cuasay2/Backpack-Buddy/Hardware/ATMEGA32U4-AU.step

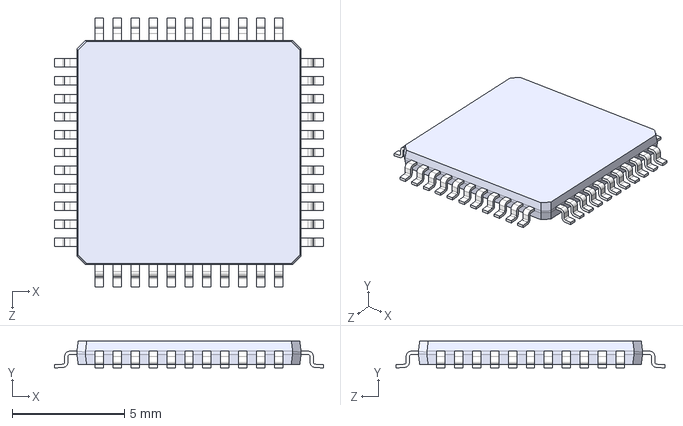
[picture p2: CAD file, 2023-02-20]
Hardware/ATMEGA32U4-AU.step
12.0 x 1.20 x 12.0 mm
