cuasay2/Backpack-Buddy/Hardware/System/backpackbuddy_system/backpackbuddy_system.kicad_pcb

## KiCad design Hardware/System/backpackbuddy_system/backpackbuddy_system.kicad_pcb (2023-04-06)

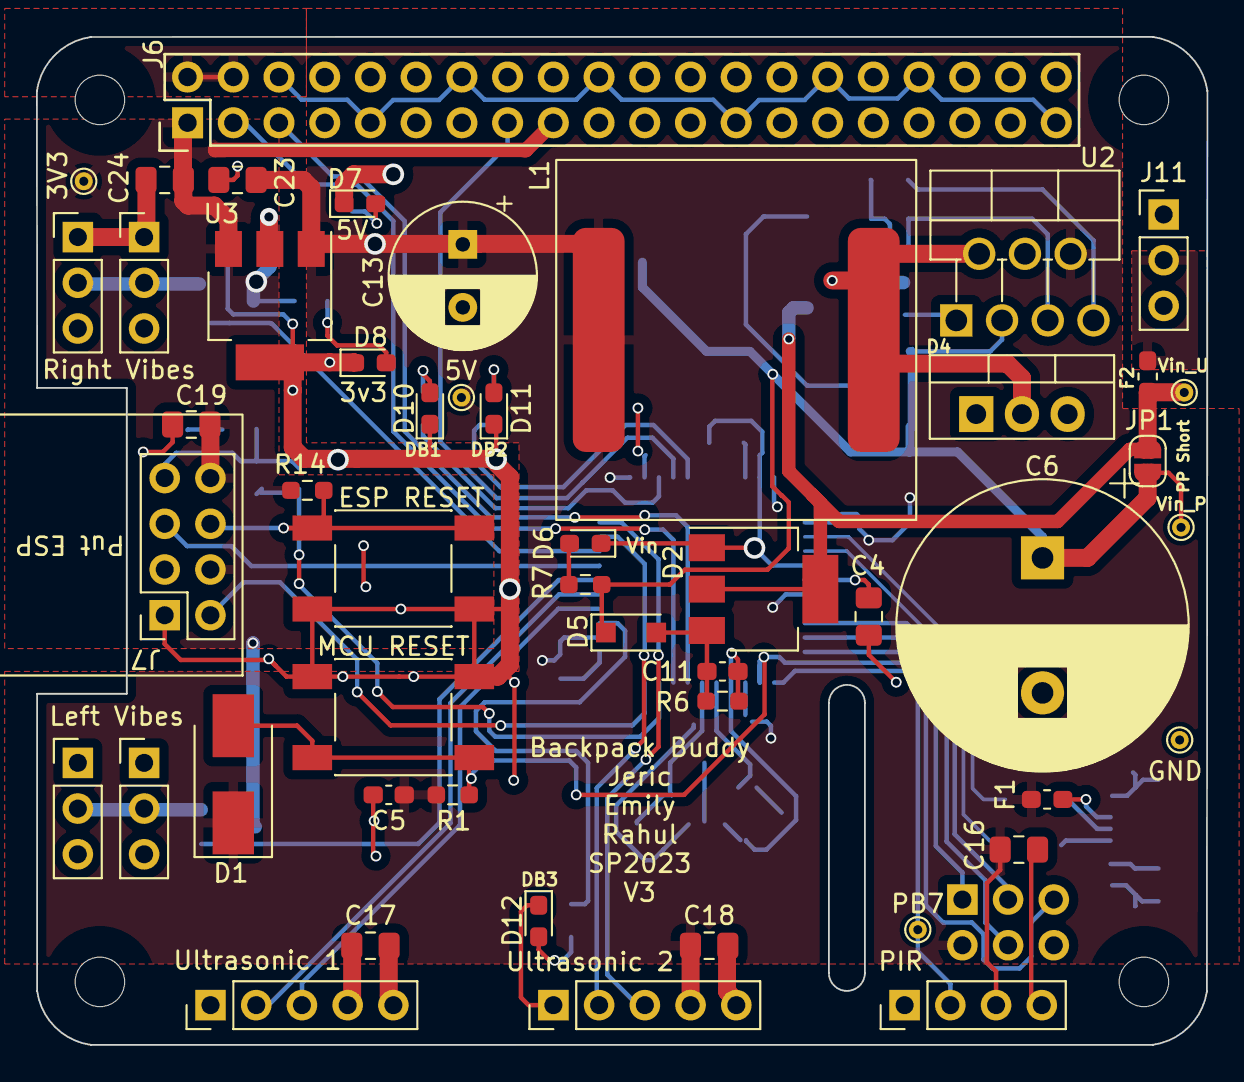
[picture p3: board backpackbuddy_system.kicad_pcb from above]

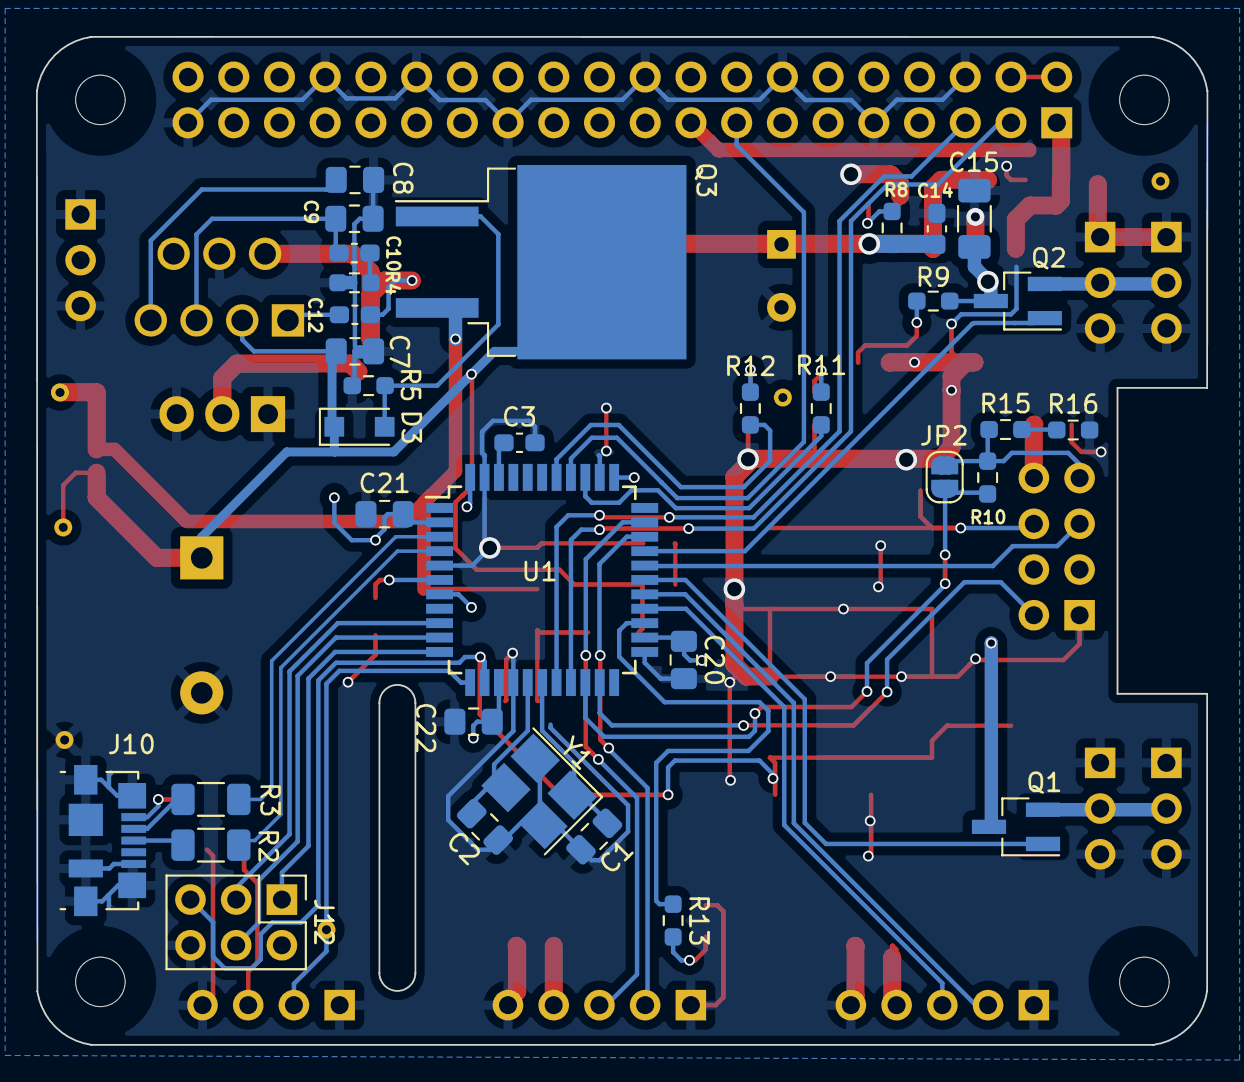
[picture p4: board backpackbuddy_system.kicad_pcb from below]

Board: 2 copper layers, 65.0 x 56.0 mm, 87 parts (34 on the bottom side), 53 nets.

Parts:
C1, C2: 22pF; C_0805_2012Metric_Pad1.18x1.45mm_HandSolder
C3, C5, C11: 0.1uF; C_0603_1608Metric_Pad1.08x0.95mm_HandSolder
C4: 1uF; C_0805_2012Metric_Pad1.18x1.45mm_HandSolder
C6: 2200uF; CP_Radial_D16.0mm_P7.50mm
C7: 4.7uF; C_0805_2012Metric_Pad1.18x1.45mm_HandSolder
C8, C16, C17, C18, C19, C20, C21, C22, C23, C24: 10uF; C_0805_2012Metric_Pad1.18x1.45mm_HandSolder
C9: 680pF; C_0805_2012Metric_Pad1.18x1.45mm_HandSolder
C10: 1200pF; C_0603_1608Metric_Pad1.08x0.95mm_HandSolder
C12: 0.22uF; C_0603_1608Metric_Pad1.08x0.95mm_HandSolder
C13: 470uF; CP_Radial_D8.0mm_P3.50mm
C14: 0.47uF; C_0603_1608Metric_Pad1.08x0.95mm_HandSolder
C15: 33uF; C_1206_3216Metric_Pad1.33x1.80mm_HandSolder
D1: 1V; D_SMB_Handsoldering
D2: S602TS; SOT-223-3_TabPin2
D3: 20V; D_SOD-123F
D4: FMW-2156; TO-220-3_Vertical
D5: 27V; D_SOD-123F
D6: Vin; LED_0603_1608Metric_Pad1.05x0.95mm_HandSolder
D7: 5V; LED_0603_1608Metric_Pad1.05x0.95mm_HandSolder
D8: 3v3; LED_0603_1608Metric_Pad1.05x0.95mm_HandSolder
D10: DB1; LED_0603_1608Metric_Pad1.05x0.95mm_HandSolder
D11: DB2; LED_0603_1608Metric_Pad1.05x0.95mm_HandSolder
D12: DB3; LED_0603_1608Metric_Pad1.05x0.95mm_HandSolder
F1: 500mA; Fuse_0603_1608Metric_Pad1.05x0.95mm_HandSolder
F2: 4A; Fuse_0603_1608Metric_Pad1.05x0.95mm_HandSolder
H1, H2, H3, H4: MountingHole; RPi_Hat_Mounting_Hole
J1: PIR; PinHeader_1x04_P2.54mm_Vertical
J2: Ultrasonic 2; PinHeader_1x05_P2.54mm_Vertical
J3: Ultrasonic 1; PinHeader_1x05_P2.54mm_Vertical
J4: Left Vibes; PinHeader_1x03_P2.54mm_Vertical
J5: Left Vibration 2; PinHeader_1x03_P2.54mm_Vertical
J6: RPi_GPIO; Pin_Header_Straight_2x20
J7: ESP8266
J8: Right Vibes; PinHeader_1x03_P2.54mm_Vertical
J9: Right Vibration 2; PinHeader_1x03_P2.54mm_Vertical
J10: USB_B_Micro; USB_Micro-B_Molex_47346-0001
J11: Battery; PinHeader_1x03_P2.54mm_Vertical
J12: ICSP; PinHeader_2x03_P2.54mm_Vertical
JP1, JP2: PP Short; SolderJumper-2_P1.3mm_Open_RoundedPad1.0x1.5mm
L1: 56uH; Inductor_IHLP6767GZER560M11
PB7: PIR; TestPoint_THTPad_D1.0mm_Drill0.5mm
Q1, Q2: Q_NMOS_GSD; SOT-23_Handsoldering
Q3: SIHF9Z24STRR-GE3; TO-263-2
R1, R7, R14: 10k; R_0603_1608Metric_Pad0.98x0.95mm_HandSolder
R2, R3: 22; R_1206_3216Metric_Pad1.30x1.75mm_HandSolder
R4: 39k; R_0603_1608Metric_Pad0.98x0.95mm_HandSolder
R5, R6, R8, R9, R10, R11, R12, R13, R15, R16: 1k; R_0603_1608Metric_Pad0.98x0.95mm_HandSolder
SW1: ESP RESET; RST_SW
SW2: MCU RESET; RST_SW
TP1: Vin_U; TestPoint_THTPad_D1.0mm_Drill0.5mm
TP2: GND; TestPoint_THTPad_D1.0mm_Drill0.5mm
TP3: Vin_P; TestPoint_THTPad_D1.0mm_Drill0.5mm
TP4: 5V; TestPoint_THTPad_D1.0mm_Drill0.5mm
TP5: 3V3; TestPoint_THTPad_D1.0mm_Drill0.5mm
U1: ATmega32U4-A; TQFP-44_10x10mm_P0.8mm
U2: SI-8050Y; TO-220F-7_P2.54x3.7mm_StaggerOdd_Lead3.5mm_Vertical
U3: LM3940; SOT-223
Y1: 16MHz; Crystal_SMD_3225-4Pin_3.2x2.5mm_HandSoldering

Connections:
+3V3: C15.1, C19.1, C24.1, J6.1, J6.17, J7.4, J7.8, Q1.3 (D), Q2.3 (D), R9.1, R14.1, TP5.1, U3.3 (Vout)
+5V: C5.1, C13.1, C14.1, C16.1, C17.1, C18.1, C20.1, C21.1, C22.1, C23.1, D1.1 (K), F1.2, J1.3, J2.4, J3.4, J6.2, J6.4, J12.2, L1.2, R1.1, R8.1, TP4.1, U1.2 (UVCC), U1.7 (VBUS), U1.14 (VCC), U1.24 (AVCC), U1.34 (VCC), U1.44 (AVCC), U2.6 (FB), U3.1 (Vin)
/ESP RESET: J7.6, R14.2, SW1.1
/ESP_RX: J7.7, JP2.1 (A), R10.2, R15.1
/MISO: J12.1, U1.11 (PB3)
/MOSI: J12.4, U1.10 (PB2)
/PD2/RX: JP2.2 (B), R10.1, U1.20 (PD2)
/Power/18V PROTECTED: C6.1, C7.1, D3.1 (K), D5.1 (K), JP1.2 (B), Q3.2 (D), R7.1, TP3.1, U2.3 (IN)
/RESET: D1.2 (A), J12.5, R1.2, SW2.1, U1.13 (~RESET)
/Raspberry Pi/GPIO2_SDA: J6.3, U1.19 (PD1)
/Raspberry Pi/GPIO3_SCL: J6.5, U1.18 (PD0)
/Raspberry Pi/GPIO22: J6.15, U1.37 (PF6)
/SCLK: J12.3, U1.9 (PB1)
/microcontroller/D+: R2.2, U1.4 (D+)
/microcontroller/D-: R3.2, U1.3 (D-)
/microcontroller/PB4: Q1.1 (G), U1.28 (PB4)
/microcontroller/PB5: J7.5, U1.29 (PB5)
/microcontroller/PB6: Q2.1 (G), U1.30 (PB6)
/microcontroller/PB7: J1.2, PB7.1, U1.12 (PB7)
/microcontroller/PC6: J2.2, U1.31 (PC6)
/microcontroller/PC7: J2.3, U1.32 (PC7)
/microcontroller/PD3/TX: J7.2, U1.21 (PD3)
/microcontroller/PD4: R13.1, U1.25 (PD4)
/microcontroller/PD6: J3.3, U1.26 (PD6)
/microcontroller/PD7: J3.2, U1.27 (PD7)
/microcontroller/PF5: R12.1, U1.38 (PF5)
/microcontroller/PF7: R11.1, U1.36 (PF7)
GND: C1.1, C2.1, C3.2, C4.2, C5.2, C6.2, C7.2, C8.2, C9.2, C11.2, C13.2, C14.2, C15.2, C16.2, C17.2, C18.2, C19.2, C20.2, C21.2, C22.2, C23.2, C24.2, D2.1 (K), D4.1 (A), D4.3 (A), D6.1 (K), D7.1 (K), D8.1 (K), D10.1 (K), D11.1 (K), D12.1 (K), J1.1, J1.4, J2.1, J2.5, J3.1, J3.5, J4.1, J4.3, J5.1, J5.3, J6.6, J6.9, J6.14, J6.20, J6.25, J6.30, J6.34, J6.39, J7.1, J8.1, J8.3, J9.1, J9.3, J10.5 (GND), J10.6 (Shield), J11.1, J11.3, J12.6, R4.2, R5.2, R6.2, R16.2, SW1.2, SW2.2, TP2.1, U1.5 (UGND), U1.15 (GND), U1.23 (GND), U1.35 (GND), U1.43 (GND), U2.4 (GND), U3.2 (GND), U3.4 (GND), Y1.2, Y1.4
unnamed: C1.2, U1.17 (XTAL1), Y1.1
unnamed: C2.2, U1.16 (XTAL2), Y1.3
unnamed: C3.1, U1.42 (AREF)
unnamed: C4.1, U1.6 (UCAP)
unnamed: C8.1, U2.7 (EN/SS)
unnamed: C9.1, C10.1, U2.5 (COMP)
unnamed: C10.2, R4.1
unnamed: C11.1, D2.3 (G), D5.2 (A), R6.1
unnamed: C12.1, U2.1 (BS)
unnamed: C12.2, D4.2 (K), L1.1, U2.2 (SW)
unnamed: D2.2 (A), F2.2, JP1.1 (A), Q3.3 (S), TP1.1
unnamed: D3.2 (A), Q3.1 (G), R5.1
unnamed: D6.2 (A), R7.2
unnamed: D7.2 (A), R8.2
unnamed: D8.2 (A), R9.2
unnamed: D10.2 (A), R11.2
unnamed: D11.2 (A), R12.2
unnamed: D12.2 (A), R13.2
unnamed: F1.1, J10.1 (VBUS)
unnamed: F2.1, J11.2
unnamed: J4.2, J5.2, Q1.2 (S)
unnamed: J8.2, J9.2, Q2.2 (S)
unnamed: J10.2 (D-), R3.1
unnamed: J10.3 (D+), R2.1
unnamed: R15.2, R16.1
