cuasay2/Backpack-Buddy/Hardware/Power/power_v1/power_v1.kicad_sch

## KiCad design Hardware/Power/power_v1/power_v1.kicad_sch (2023-02-28)

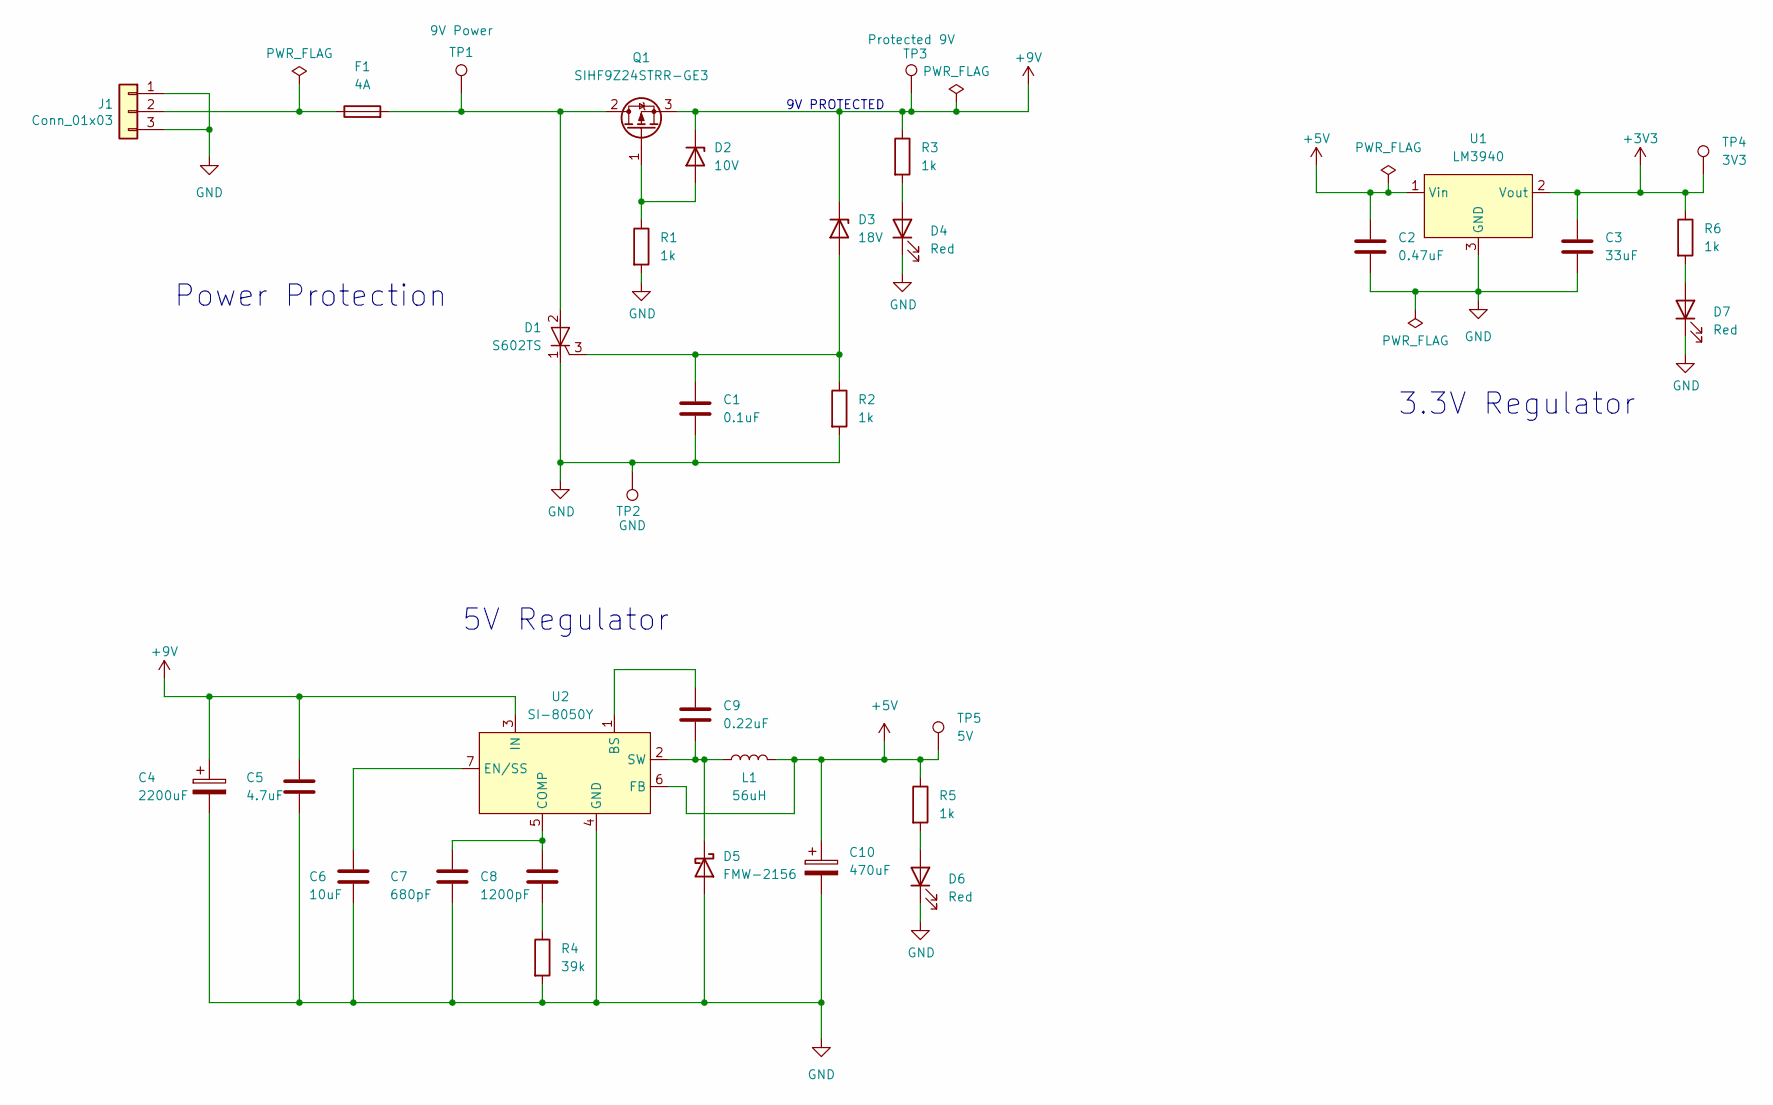
[picture p5: schematic power_v1.kicad_sch]

Parts:
C1: 0.1uF; C_0603_1608Metric_Pad1.05x0.95mm_HandSolder; MPN CAP CER 0.1UF 50V X7R 0603
C2: 0.47uF; C_0603_1608Metric_Pad1.05x0.95mm_HandSolder; MPN CAP CER 0.47UF 16V X7R 0603
C3: 33uF; C_1206_3216Metric_Pad1.33x1.80mm_HandSolder; MPN CAP CER 33UF 25V X5R 1206
C4: 2200uF; CP_Radial_D16.0mm_P7.50mm; MPN CAP ALUM 2200UF 20% 50V RADIAL
C5: 4.7uF; C_0805_2012Metric_Pad1.18x1.45mm_HandSolder; MPN CAP CER 4.7UF 50V X5R 0805
C6: 10uF; C_0805_2012Metric_Pad1.18x1.45mm_HandSolder; MPN CAP CER 10UF 25V X5R 0805
C7: 680pF; C_0805_2012Metric_Pad1.18x1.45mm_HandSolder; MPN CAP CER 680PF 200V X7R 0805
C8: 1200pF; C_0603_1608Metric_Pad1.05x0.95mm_HandSolder; MPN CAP CER 1200PF 50V NP0 0805
C9: 0.22uF; C_0603_1608Metric_Pad1.05x0.95mm_HandSolder; MPN CAP CER 0.22UF 50V X7R 0603
C10: 470uF; CP_Radial_D8.0mm_P3.50mm; MPN CAP ALUM 470UF 20% 25V RADIAL
D1: S602TS; SOT-223-3_TabPin2; MPN S602TSRP
D2: 10V; D_SOD-123F; MPN NZH10C
D3: 18V; D_SOD-123F; MPN NZH18C
D4, D6, D7: Red; LED_0603_1608Metric_Pad1.05x0.95mm_HandSolder; MPN LED RED 0603 SMD
D5: FMW-2156; TO-220-3_Vertical; MPN FMW-2156
F1: 4A; Fuse_0603_1608Metric_Pad1.05x0.95mm_HandSolder; MPN SF-0603SPA500R-2
J1: Conn_01x03; Molex_KK-254_AE-6410-03A_1x03_P2.54mm_Vertical; MPN 0022232031
L1: 56uH; Inductor_IHLP6767GZER560M11; MPN FIXED IND 56UH 7.2A 57.8MOHM SMD
Q1: SIHF9Z24STRR-GE3; TO-263-2; MPN SIHF9Z24STRR-GE3
R1, R2, R3, R5, R6: 1k; R_0603_1608Metric_Pad1.05x0.95mm_HandSolder; MPN RES SMD 1K OHM 1% 1/8W 0603
R4: 39k; R_0603_1608Metric_Pad1.05x0.95mm_HandSolder; MPN RES SMD 39K OHM 1% 1/10W 0603
TP1: 12V Unprotected; TestPoint_THTPad_D1.0mm_Drill0.5mm
TP2: GND; TestPoint_THTPad_D1.0mm_Drill0.5mm
TP3: Protected 9V; TestPoint_THTPad_D1.0mm_Drill0.5mm
TP4: 3V3; TestPoint_THTPad_D1.0mm_Drill0.5mm
TP5: 5V; TestPoint_THTPad_D1.0mm_Drill0.5mm
U1: LM3940; SOT-223; MPN LM3940
U2: SI-8050Y; TO-220F-7_P2.54x3.7mm_StaggerEven_Lead3.5mm_Vertical; MPN SI-8050Y

Connections:
+3V3: C3.1, R6.1, TP4.1, U1.2 (Vout)
+5V: C2.1, C10.1, L1.2, R5.1, TP5.1, U1.1 (Vin), U2.6 (FB)
+9V: C4.1, C5.1, D2.1 (K), D3.1 (K), Q1.3 (S), R3.1, TP3.1, U2.3 (IN)
GND: C1.2, C2.2, C3.2, C4.2, C5.2, C6.2, C7.2, C10.2, D1.1 (K), D4.1 (K), D5.2 (A), D6.1 (K), D7.1 (K), J1.1, J1.3, R1.2, R2.2, R4.2, TP2.1, U1.3 (GND), U2.4 (GND)
unnamed: C1.1, D1.3 (G), D3.2 (A), R2.1
unnamed: C6.1, U2.7 (EN/SS)
unnamed: C7.1, C8.1, U2.5 (COMP)
unnamed: C8.2, R4.1
unnamed: C9.1, U2.1 (BS)
unnamed: C9.2, D5.1 (K), L1.1, U2.2 (SW)
unnamed: D1.2 (A), F1.2, Q1.2 (D), TP1.1
unnamed: D2.2 (A), Q1.1 (G), R1.1
unnamed: D4.2 (A), R3.2
unnamed: D6.2 (A), R5.2
unnamed: D7.2 (A), R6.2
unnamed: F1.1, J1.2

Notes on the sheet:
9V PROTECTED
Power Protection
3.3V Regulator
5V Regulator
