cuasay2/Backpack-Buddy/(commit log)

2023-02-19 first kicad test schematic
    [power_v1.kicad_pcb, power_v1.kicad_sch]
2023-02-19 started 12 to 5V sch
    [power_v1.kicad_sch]
2023-02-19 progress on power circuit
    [power_v1.kicad_sch]
2023-02-20 created mcu symbol
    [ATMEGA32U4-AU.step, control_v1.kicad_pcb, control_v1.kicad_sch, power_v1.kicad_sch]
2023-02-20 added LED indicators
    [power_v1.kicad_sch]
2023-02-24 fixed all library issues and ERC errors
    [power_v1.kicad_sch]
2023-02-25 fixed C6 and F1, chose L1 part and created footprint for it
    [power_v1.kicad_sch]
2023-02-27 more changes
    [backpackbuddy_system.kicad_sch, microcontroller.kicad_sch]
2023-02-27 vibration stuff
    [backpackbuddy_system.kicad_sch]
2023-02-27 added safe connectors
    [backpackbuddy_system.kicad_sch]
2023-02-28 labels and stuff almost done
    [backpackbuddy_system.kicad_sch, microcontroller.kicad_sch, usb.kicad_sch]
2023-02-28 combining both sheets
    [backpackbuddy_system.kicad_sch, microcontroller.kicad_sch, power.kicad_sch, usb.kicad_sch]
2023-02-28 more integration changes
    [backpackbuddy_system.kicad_sch, power.kicad_sch]
2023-02-28 updated fields
    [backpackbuddy_system.kicad_sch, control_v1.kicad_pcb, control_v1.kicad_sch, microcontroller.kicad_sch, usb.kicad_sch]
2023-02-28 schematic mostly done, just need to fix ERC, decoup caps, TP
    [backpackbuddy_system.kicad_sch, microcontroller.kicad_sch, power.kicad_sch, usb.kicad_sch]
2023-03-02 random other sch changes
    [backpackbuddy_system.kicad_sch, power.kicad_sch, usb.kicad_sch]
2023-03-02 fixed an error
    [backpackbuddy_system.kicad_sch, microcontroller.kicad_sch, power.kicad_sch, usb.kicad_sch]
2023-03-02 fixed layout errors
    [backpackbuddy_system.kicad_pcb, backpackbuddy_system.kicad_sch, microcontroller.kicad_sch, power.kicad_sch, usb.kicad_sch]
2023-03-02 added ESP8266 footprint, more testpoints, mounting holes
    [backpackbuddy_system.kicad_sch]
2023-03-02 modified esp8266 footprint
2023-03-05 fixed L1 footprint
2023-03-05 fixed lm3940 symbol, changed crystal stuff
    [backpackbuddy_system.kicad_pcb, backpackbuddy_system.kicad_sch, microcontroller.kicad_sch, power.kicad_sch]
2023-03-05 fixed table values
    [backpackbuddy_system.kicad_pcb, backpackbuddy_system.kicad_sch, microcontroller.kicad_sch, power.kicad_sch]
2023-03-05 changed LED resistor value
    [backpackbuddy_system.kicad_sch, power.kicad_sch]
2023-03-05 changed D1, the MCU reset switch diode from 50V to 1V, changed crystal caps to 22pF
    [backpackbuddy_system.kicad_sch, microcontroller.kicad_sch, power.kicad_sch, usb.kicad_sch]
2023-03-05 pp: flipped Q3 pins, changed values for D3 and D5 and updated datasheets; also fixed solder jump short pp such that its fused
    [backpackbuddy_system.kicad_sch, power.kicad_sch]
2023-03-05 adding the raspberry pi io-shield template files
    [RPi_GPIO.sch, RPi_Hat.kicad_pcb, RPi_Hat.sch]
2023-03-06 about to go crazy with the raspberry pi setup on schematic then will layout after dinner hehe
    [RPi_GPIO.kicad_sch, backpackbuddy_system.kicad_pcb, backpackbuddy_system.kicad_sch, microcontroller.kicad_sch, power.kicad_sch, usb.kicad_sch]
2023-03-06 pin matched everything
    [RPi_GPIO.kicad_sch]
2023-03-06 pull down resistor to ESP reset
    [RPi_GPIO.kicad_sch, backpackbuddy_system.kicad_sch]
2023-03-06 decoupling caps
    [RPi_GPIO.kicad_sch, backpackbuddy_system.kicad_pcb, backpackbuddy_system.kicad_sch, microcontroller.kicad_sch, power.kicad_sch, usb.kicad_sch]
2023-03-06 board outline redo
    [RPi_GPIO.kicad_sch, backpackbuddy_system.kicad_pcb, backpackbuddy_system.kicad_sch]
2023-03-06 components placed time to wire
    [backpackbuddy_system.kicad_pcb]
2023-03-06 almost done
    [RPi_GPIO.kicad_sch, backpackbuddy_system.kicad_pcb, backpackbuddy_system.kicad_sch, microcontroller.kicad_sch]
2023-03-06 first draft done :))) still errors but thats because i was too lazy to do no connects as of rn
    [RPi_GPIO.kicad_sch, backpackbuddy_system.kicad_pcb, backpackbuddy_system.kicad_sch, microcontroller.kicad_sch, power.kicad_sch, usb.kicad_sch]
2023-03-07 silkscreen done
    [backpackbuddy_system.kicad_pcb, backpackbuddy_system.kicad_sch]
2023-03-07 minor thingies
    [backpackbuddy_system.kicad_pcb]
2023-03-07 updated silkscreen
    [backpackbuddy_system.kicad_pcb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]
2023-03-15 added directories for arduino and rpi code
2023-03-17 fixed reset state with LEDs
    [arduino_follower_basic.ino]
2023-03-21 Board run 2 start -> rewire arduino connections
    [RPi_GPIO.kicad_sch, backpackbuddy_system.kicad_pcb, backpackbuddy_system.kicad_sch, microcontroller.kicad_sch, power.kicad_sch, usb.kicad_sch]
2023-03-21 pcb redone
    [backpackbuddy_system.kicad_pcb]
2023-03-26 updated thing
    [backpackbuddy_system-B_Cu.gbr, backpackbuddy_system-B_Mask.gbr, backpackbuddy_system-B_Silkscreen.gbr, backpackbuddy_system-Edge_Cuts.gbr, backpackbuddy_system-F_Cu.gbr, backpackbuddy_system-F_Mask.gbr, backpackbuddy_system-F_Silkscreen.gbr, backpackbuddy_system-NPTH.drl]
2023-04-05 version 3 board
    [backpackbuddy_system.kicad_pcb, backpackbuddy_system.kicad_sch, microcontroller.kicad_sch]
2023-04-05 version 3 fixed some silkscreen
    [backpackbuddy_system.kicad_pcb]
2023-04-05 pp short
    [backpackbuddy_system-B_Cu.gbr, backpackbuddy_system-B_Mask.gbr, backpackbuddy_system-B_Silkscreen.gbr, backpackbuddy_system-Edge_Cuts.gbr, backpackbuddy_system-F_Cu.gbr, backpackbuddy_system-F_Mask.gbr, backpackbuddy_system-F_Silkscreen.gbr, backpackbuddy_system-NPTH.drl]
2023-04-24 backup plan arduino code
